SimonSchoenfeld/FumeExtractor/images/on.png

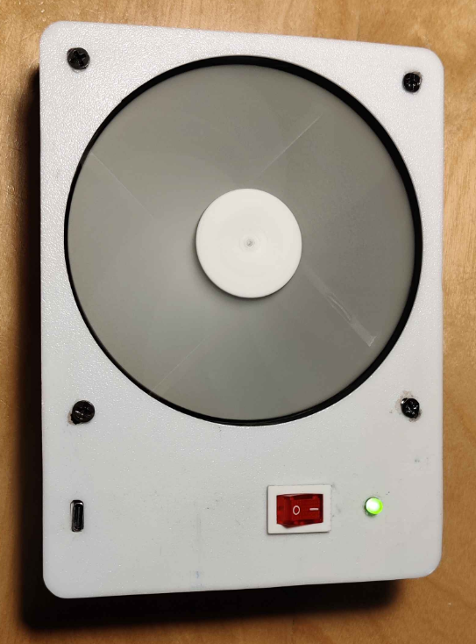
images/on.png
