SimonSchoenfeld/FumeExtractor/images/sketch.pdf

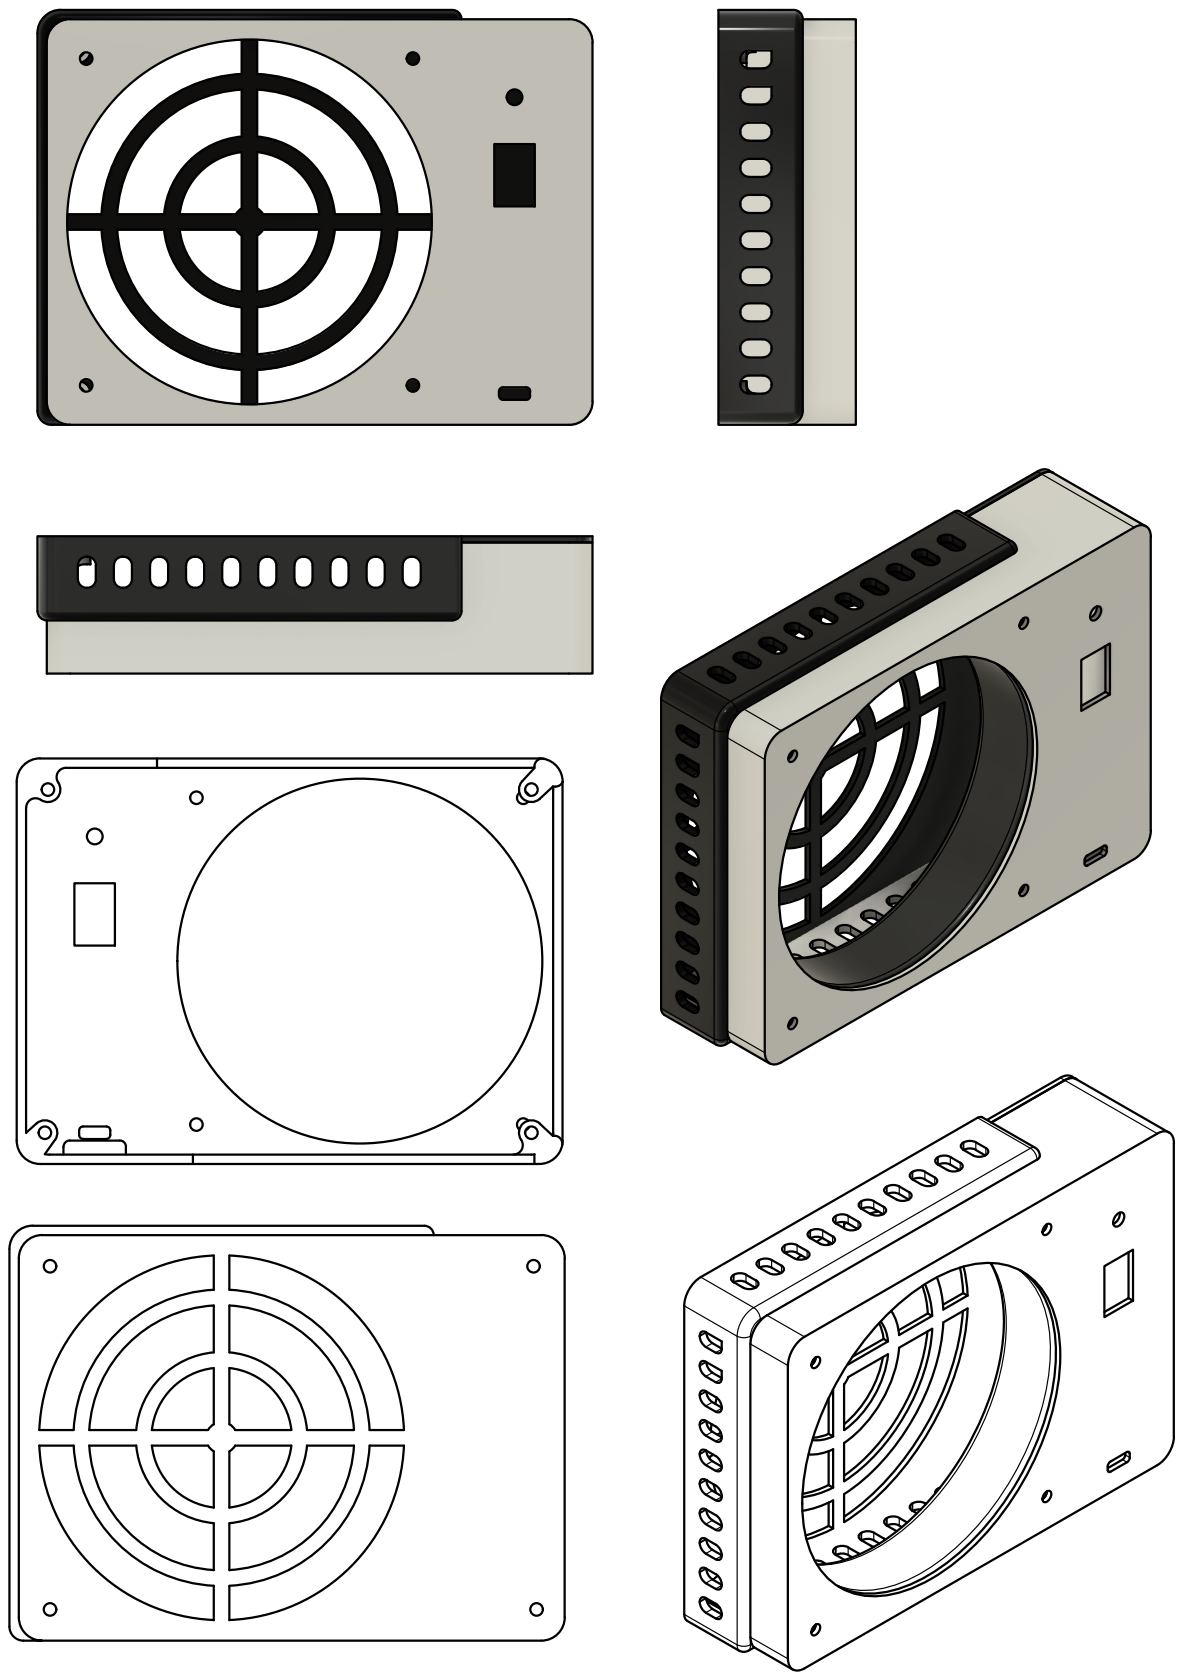
[picture p10: page 1]
