SimonSchoenfeld/FumeExtractor/STL-files/Fume_front.stl

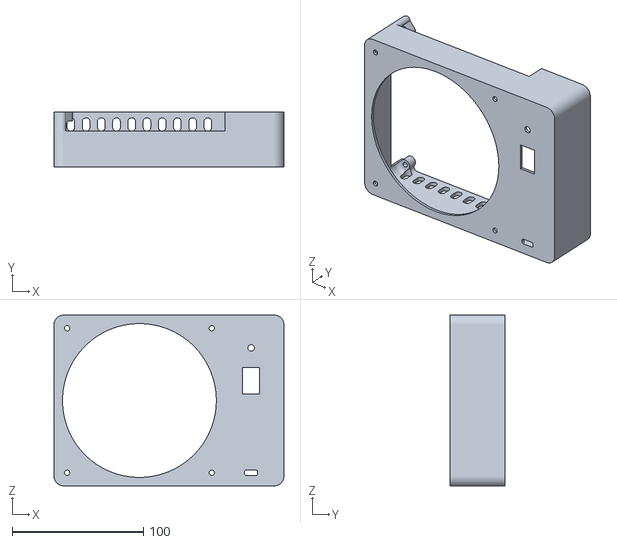
[picture p8: CAD file, 2024-08-08]
STL-files/Fume_front.stl
175.0 x 42.0 x 130.0
