SimonSchoenfeld/FumeExtractor/STL-files/Fume_back.stl

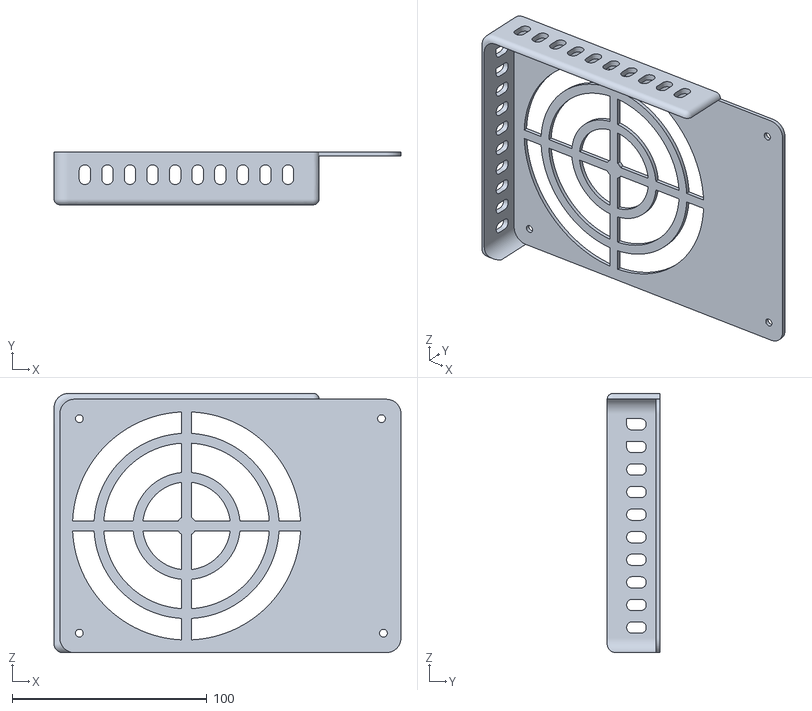
[picture p9: CAD file, 2024-08-08]
STL-files/Fume_back.stl
178.0 x 27.0 x 133.0
